trol73/avr-ic-tester/README.md

# avr-ic-tester

Тестер цифровых микросхем на atmega32 и дисплее от Nokia 5110

Описание проекта тут: http://trolsoft.ru/sch/ic_tester
