trol73/avr-ic-tester/circuit/tester-schematic.pdf

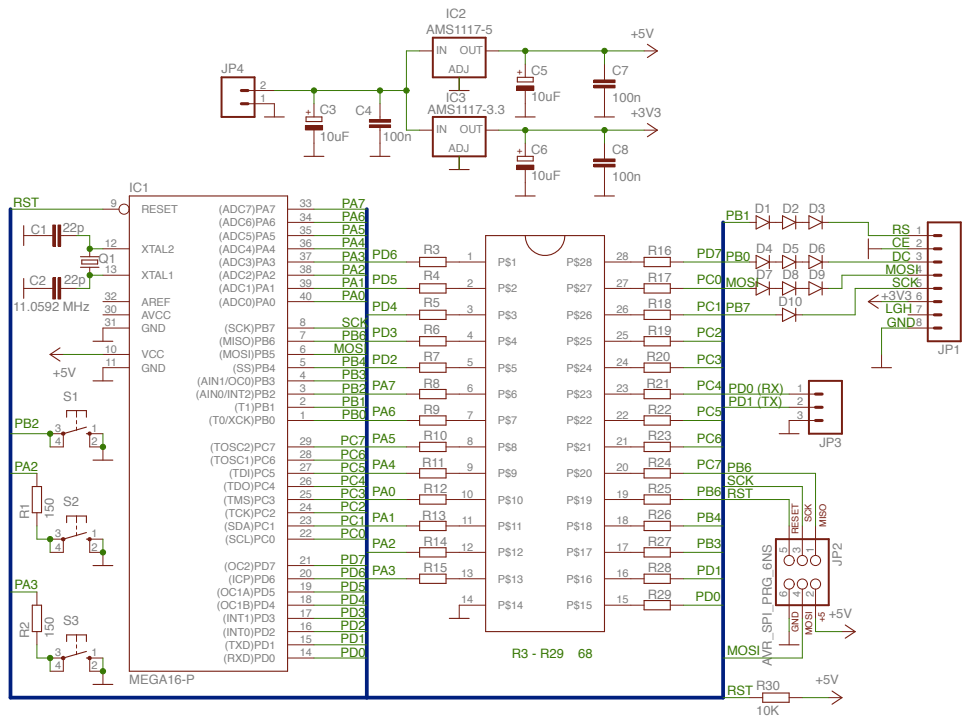
[picture p1: page 1]

GND 31 AVCC 30 AREF 32 | SCK

VCC 10 | PB6

MOSI | PD2 | P$5 5 | PC3

PC7 | PA5 | P$8 8 | PC6
PC6 | PA4 R11 | P$9 9 | R24 PC7

PA3 | P$13 13 | PD1
PD5 | | | R29 PD0
