trol73/avr-ic-tester/circuit/tester.brd

## EAGLE design circuit/tester.brd (2015-07-16)

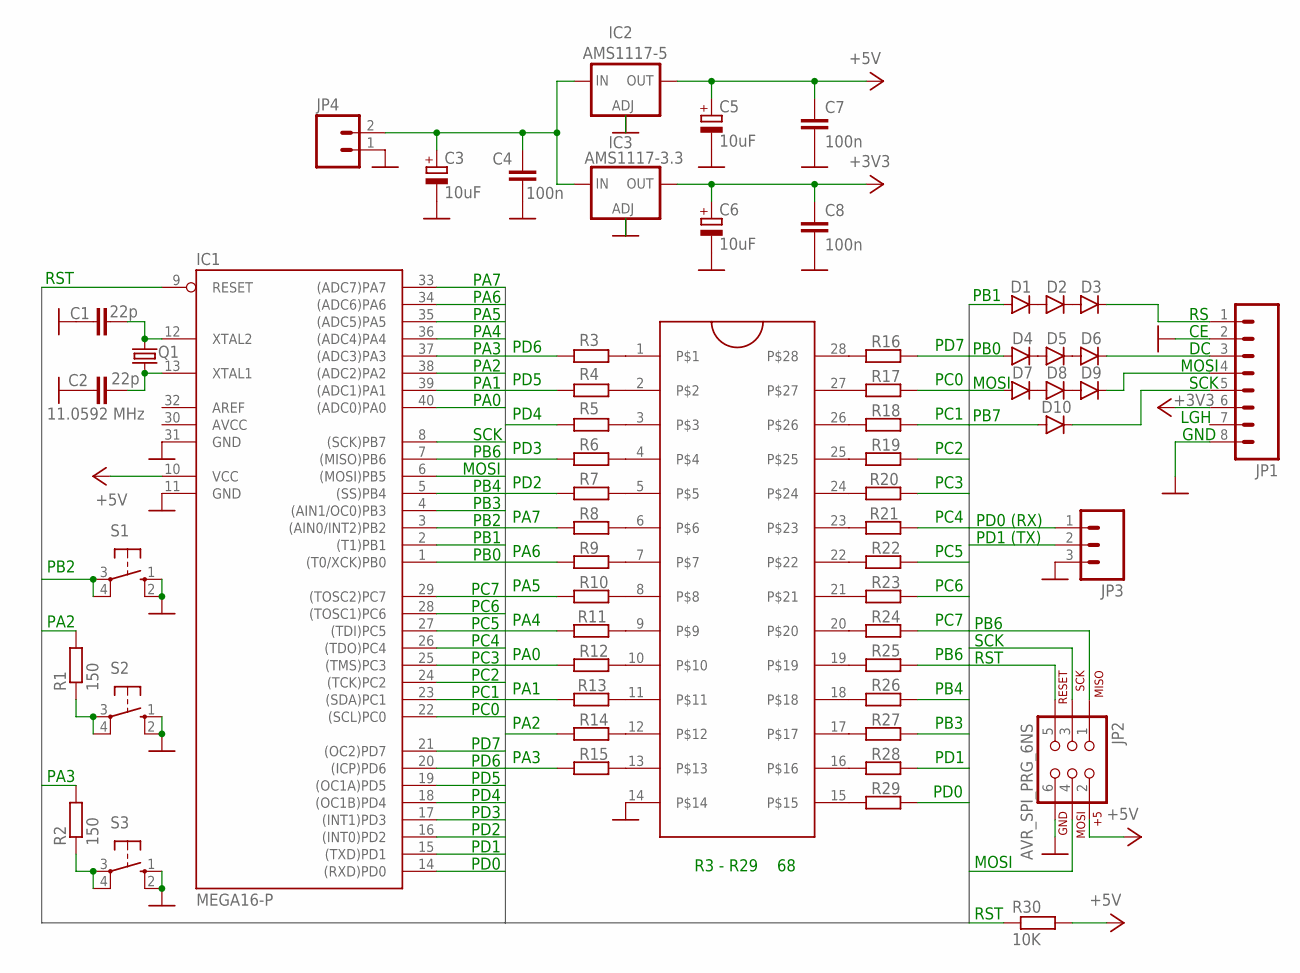
[picture p2: schematic tester.sch]

Parts:
C1, C2: 22p; C0805
C3, C5, C6: 10uF; E2,5-5
C4, C7, C8: 100n; C0805
D1, D2, D3, D4, D5, D6, D7, D8, D9, D10: DIODESOD123; SOD-123
IC1: MEGA16-P; DIL40
IC2: AMS1117-5; SOT223
IC3: AMS1117-3.3; SOT223
JP1: M08; 1X08_ROUND
JP2: AVR_SPI_PRG_6NS; 2X3-NS
JP3: M03PTH; 1X03
JP4: M02PTH; 1X02
Q1: 11.0592 MHz; HC49/S
R1, R2: 150; M0805
R3, R4, R5, R6, R7, R8, R9, R10, R11, R12, R13, R14, R15, R16, R17, R18, R19, R20, R21, R22, R23, R24, R25, R26, R27, R28, R29: R-EU_M0805; M0805
R30: 10K; M0805
S1, S2, S3: 10-XX; B3F-10XX
U$1: ZIFSOCKET-28-3ZIFFSOCKET-28-3; DIL28-3-ZIF_SOCKET

Connections:
+3V3: C6.+, C8.1, IC3.4 (OUT), JP1.6
+5V: C5.+, C7.1, IC1.10 (VCC), IC2.4 (OUT), JP2.2, R30.2
AVCC: IC1.30 (AVCC)
GND: C1.1, C2.1, C3.-, C4.1, C5.-, C6.-, C7.2, C8.2, IC1.11 (GND), IC1.31 (GND), IC2.1 (ADJ), IC3.1 (ADJ), JP1.2, JP1.8, JP2.6, JP3.3, JP4.1, S1.1 (S), S1.2 (S1), S2.1 (S), S2.2 (S1), S3.1 (S), S3.2 (S1), U$1.14
unnamed: C2.2, IC1.13 (XTAL1), Q1.1
unnamed: C1.2, IC1.12 (XTAL2), Q1.2
unnamed: R16.2, U$1.28
unnamed: R17.1, U$1.27
unnamed: R18.1, U$1.26
unnamed: R19.1, U$1.25
unnamed: R20.1, U$1.24
unnamed: R21.1, U$1.23
unnamed: R22.1, U$1.22
unnamed: R23.1, U$1.21
unnamed: R24.1, U$1.20
unnamed: R7.1, U$1.5
unnamed: R6.1, U$1.4
unnamed: R5.1, U$1.3
unnamed: R4.1, U$1.2
unnamed: R3.2, U$1.1
unnamed: R8.2, U$1.6
unnamed: R9.2, U$1.7
unnamed: R10.2, U$1.8
unnamed: R11.2, U$1.9
unnamed: R12.2, U$1.10
unnamed: R13.2, U$1.11
unnamed: R14.2, U$1.12
unnamed: R15.2, U$1.13
unnamed: R25.2, U$1.19
unnamed: R26.2, U$1.18
unnamed: R27.1, U$1.17
unnamed: R29.1, U$1.15
unnamed: R28.1, U$1.16
unnamed: C3.+, C4.2, IC2.3 (IN), IC3.3 (IN), JP4.2
unnamed: R2.1, S3.3, S3.4 (P1)
unnamed: R1.1, S2.3, S2.4 (P1)
unnamed: D3.C, JP1.1
unnamed: D1.C, D2.A
unnamed: D2.C, D3.A
unnamed: D6.C, JP1.3
unnamed: D4.C, D5.A
unnamed: D9.C, JP1.4
unnamed: D5.C, D6.A
unnamed: D7.C, D8.A
unnamed: D8.C, D9.A
unnamed: D10.C, JP1.5
PA0: IC1.40 ((ADC0)PA0), R12.1
PA1: IC1.39 ((ADC1)PA1), R13.1
PA2: IC1.38 ((ADC2)PA2), R1.2, R14.1
PA3: IC1.37 ((ADC3)PA3), R2.2, R15.1
PA4: IC1.36 ((ADC4)PA4), R11.1
PA5: IC1.35 ((ADC5)PA5), R10.1
PA6: IC1.34 ((ADC6)PA6), R9.1
PA7: IC1.33 ((ADC7)PA7), R8.1
PB0: D4.A, IC1.1 ((T0/XCK)PB0)
PB1: D1.A, IC1.2 ((T1)PB1)
PB2: IC1.3 ((AIN0/INT2)PB2), S1.3, S1.4 (P1)
PB3: IC1.4 ((AIN1/OC0)PB3), R27.2
PB4: IC1.5 ((SS)PB4), R26.1
PB5: D7.A, IC1.6 ((MOSI)PB5), JP2.4
PB6: IC1.7 ((MISO)PB6), JP2.1, R25.1
PB7: D10.A, IC1.8 ((SCK)PB7), JP2.3
PC0: IC1.22 ((SCL)PC0), R17.2
PC1: IC1.23 ((SDA)PC1), R18.2
PC2: IC1.24 ((TCK)PC2), R19.2
PC3: IC1.25 ((TMS)PC3), R20.2
PC4: IC1.26 ((TDO)PC4), R21.2
PC5: IC1.27 ((TDI)PC5), R22.2
PC6: IC1.28 ((TOSC1)PC6), R23.2
PC7: IC1.29 ((TOSC2)PC7), R24.2
PD0: IC1.14 ((RXD)PD0), JP3.1, R29.2
PD1: IC1.15 ((TXD)PD1), JP3.2, R28.2
PD2: IC1.16 ((INT0)PD2), R7.2
PD3: IC1.17 ((INT1)PD3), R6.2
PD4: IC1.18 ((OC1B)PD4), R5.2
PD5: IC1.19 ((OC1A)PD5), R4.2
PD6: IC1.20 ((ICP)PD6), R3.1
PD7: IC1.21 ((OC2)PD7), R16.1
RESET: IC1.9 (RESET), JP2.5, R30.1

Notes on the sheet:
MOSI
SCK
LGH
GND
PB7
PB6
RST
PB0
PB1
PB2
PA3
PA2
PD6
PD5
PD4
PD3
PD2
PA7
PA6
PA5
PA4
PA0
PA1
PD7
PC0
PC1
PC2
PC3
PC4
PC5
PC6
PC7
PB4
PB3
PD1
PD1 (TX)
PD0
PD0 (RX)
R3 - R29 68

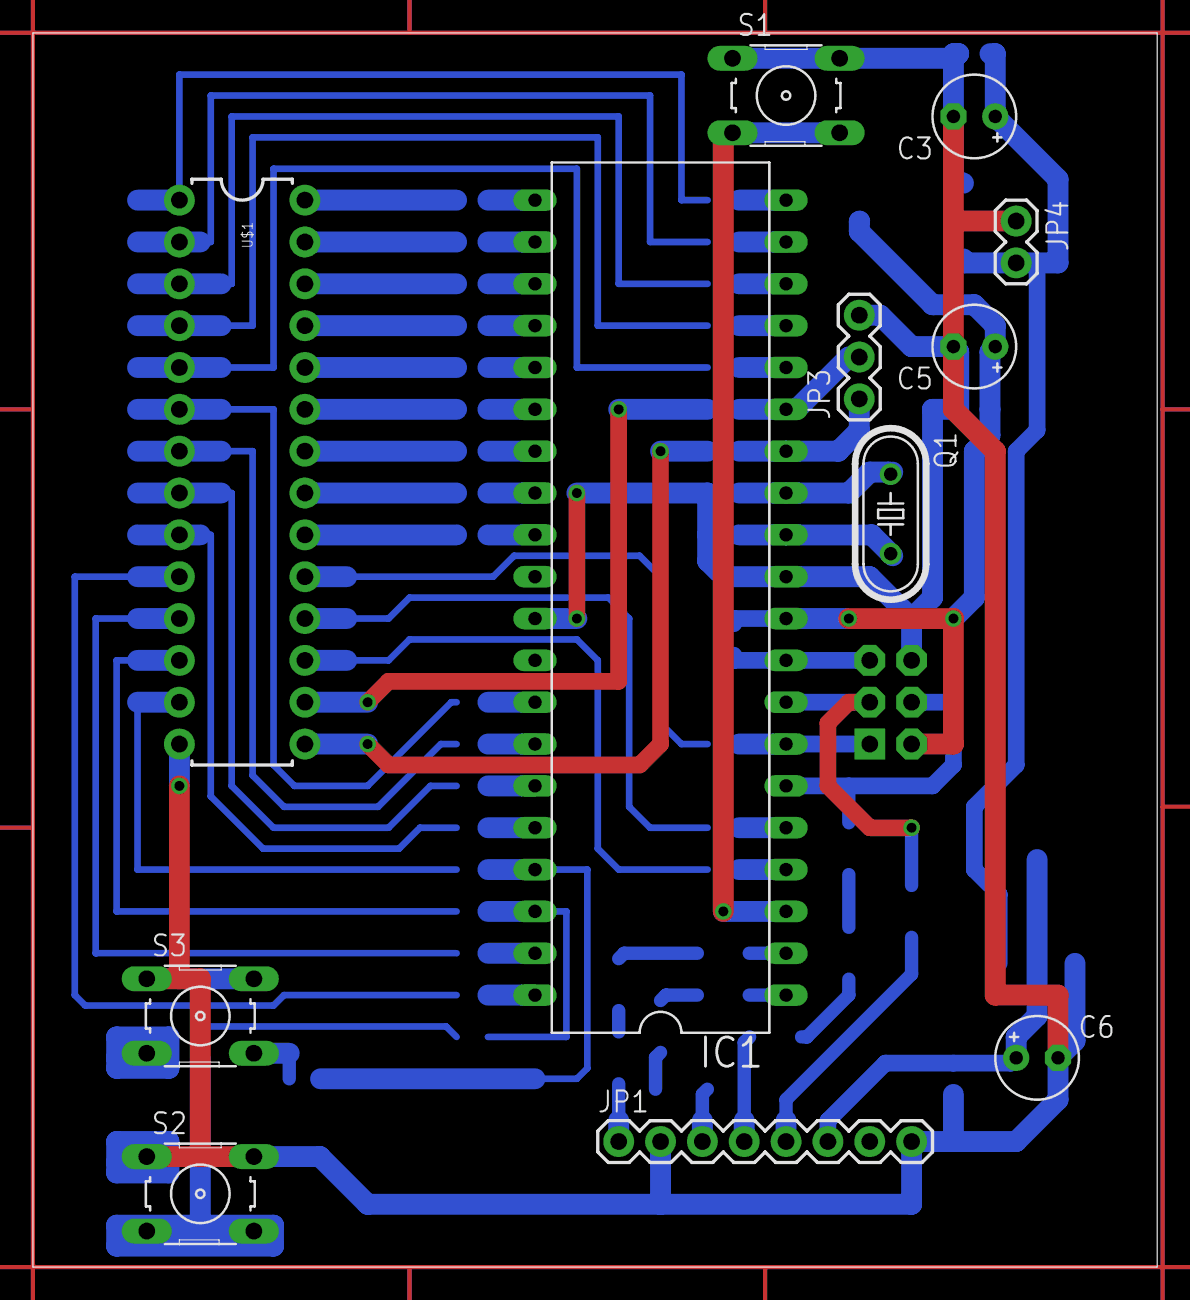
[picture p3: board tester.brd from above]

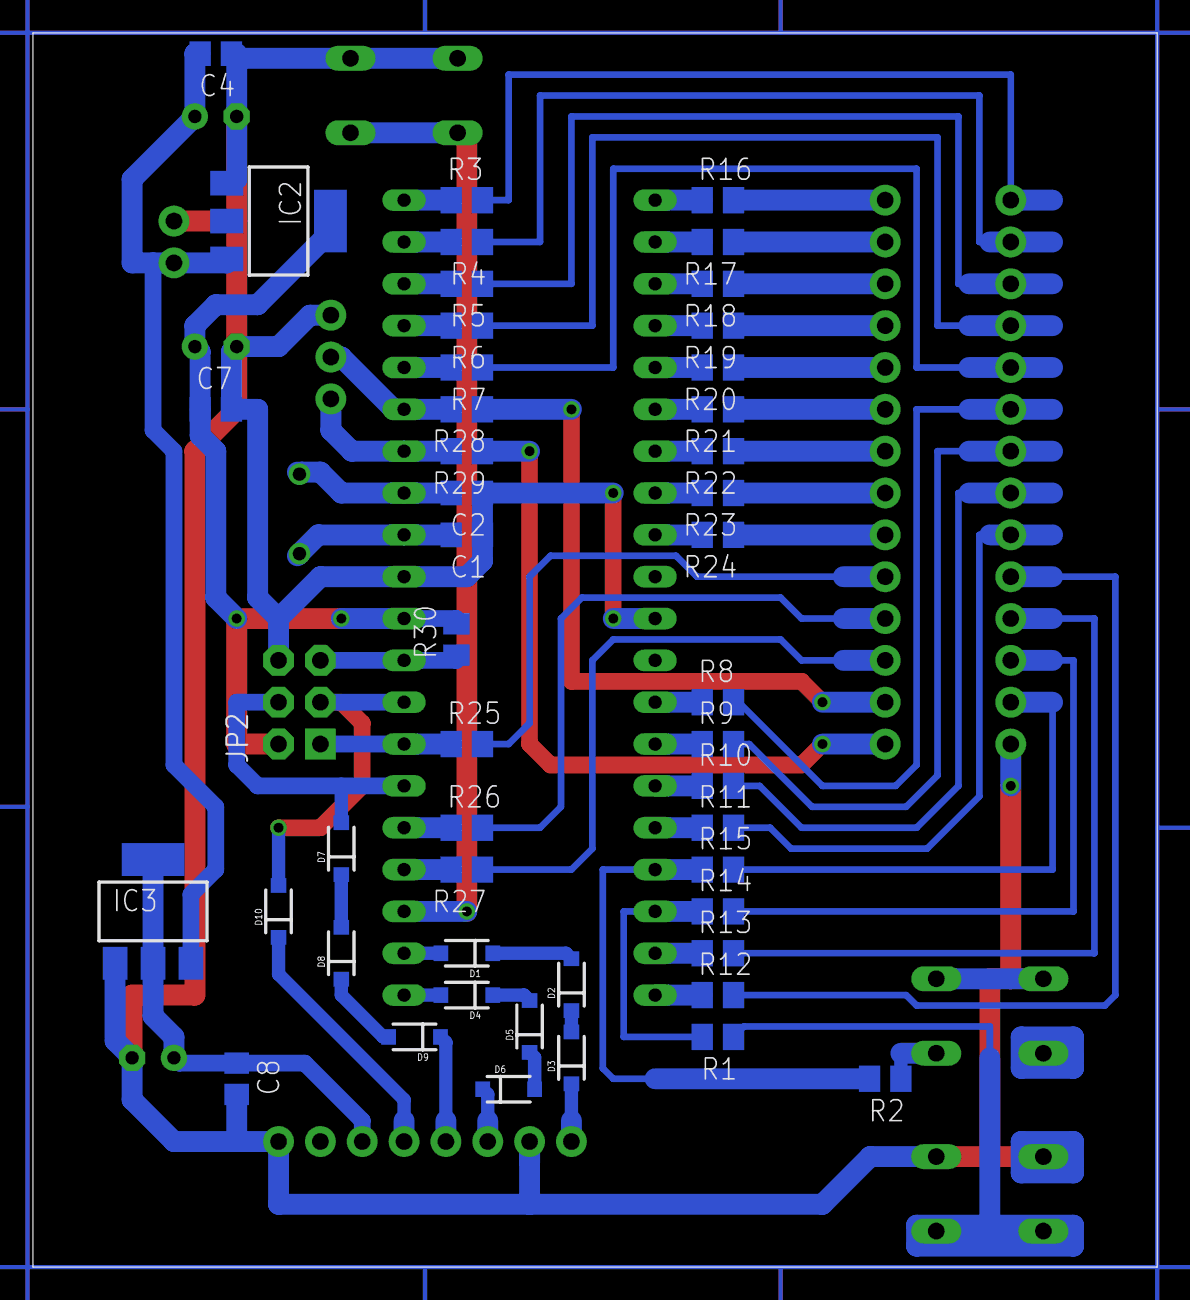
[picture p4: board tester.brd from below]

Board: 2 copper layers, 68.2 x 74.9 mm, 60 parts (48 on the bottom side), 78 nets.
