trol73/avr-ic-tester/ic-tester/data_ttl.h

const uint8_t LOGIC_DATA_TTL[] PROGMEM = {
	'Ê', 'Ð', '5', '1', '4', 'È', 'Ä', '2', 0,
	CMD_INIT_16, 0b00111111, 0b10000000,
	CMD_SET_ALL_AND_TEST_16, 0b10001100, 0b10000001, 0b10001100, 0b10000001,
	CMD_SET_ALL_AND_TEST_16, 0b10001000, 0b10000001, 0b10001000, 0b10000001,
	CMD_SET_ALL_AND_TEST_16, 0b11001000, 0b11111111, 0b11001000, 0b11111111,
	CMD_SET_ALL_AND_TEST_16, 0b11001100, 0b11111111, 0b10001100, 0b10000001,
	CMD_SET_ALL_AND_TEST_16, 0b11000100, 0b11111111, 0b10000100, 0b10100001,
	CMD_SET_ALL_AND_TEST_16, 0b11010100, 0b11111111, 0b11010100, 0b11110011,
	CMD_SET_ALL_AND_TEST_16, 0b11000101, 0b11111111, 0b10000101, 0b11000101,
	CMD_SET_ALL_AND_TEST_16, 0b11010101, 0b11111111, 0b11010101, 0b11000001,
	CMD_SET_ALL_AND_TEST_16, 0b11000110, 0b11111111, 0b11000110, 0b10010011,
	CMD_SET_ALL_AND_TEST_16, 0b11010110, 0b11111111, 0b11010110, 0b10001001,
	CMD_SET_ALL_AND_TEST_16, 0b11000111, 0b11111111, 0b10000111, 0b10001001,
	CMD_SET_ALL_AND_TEST_16, 0b11010111, 0b11111111, 0b11010111, 0b11100011,
	CMD_SET_ALL_AND_TEST_16, 0b11011100, 0b11111111, 0b11011100, 0b10000001,
	CMD_SET_ALL_AND_TEST_16, 0b11001101, 0b11111111, 0b10001101, 0b11011101,
	CMD_SET_ALL_AND_TEST_16, 0b11011101, 0b11111111, 0b11011101, 0b11011001,
	CMD_SET_ALL_AND_TEST_16, 0b11001110, 0b11111111, 0b11001110, 0b10010111,
	CMD_SET_ALL_AND_TEST_16, 0b11011110, 0b11111111, 0b11011110, 0b10001101,
	CMD_SET_ALL_AND_TEST_16, 0b11001111, 0b11111111, 0b10001111, 0b10011101,
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
	CMD_LAST_PULSE_AND_TEST_16, 0b01111111, 0b10011011,
	CMD_LAST_PULSE_AND_TEST_16, 0b01111111, 0b10111011,
	CMD_LAST_PULSE_AND_TEST_16, 0b01111111, 0b10000111,
	CMD_LAST_PULSE_AND_TEST_16, 0b01111111, 0b11100111,
	CMD_LAST_PULSE_AND_TEST_16, 0b01111111, 0b10000011,
	CMD_END,
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
