trol73/avr-ic-tester/ic-tester/ui.c

/*
 * ui.c
 *
 * Created: 27.07.2015 20:16:58
 *  Author: Trol
 */ 

#include "ui.h"

#include <string.h>
#include <stdio.h>

#include "lib/glcd/glcd.h"
#include "lib/glcd/fonts/font5x7.h"

#include "debug.h"

#include "keyboard.h"
#include "i18n.h"
#include "test.h"
#include "tester_io.h"
#include "memory_test.h"

#define LINES_PER_SCREEN			5	// строк на экране
#define LINES_DY					9	// расстояние между строками

#define STATUS_INSERT_CHIP		0	// ожидание установки микросхемы
#define STATUS_TESTING			1	// тестирование в процессе
#define STATUS_DONE				2	// тестирование завершено

#define STATUS_SETUP			0	// настройка пинов на ввод/вывод
#define STATUS_OUT				1	// установка уровней на выводах

uint8_t screen;
uint8_t selectedIndex;
uint8_t status;

uint8_t package;			// сколько выводов у микросхемы (ручной тест). тут же хранитя тип микросхемы (TTL/CMOS)



static void glcd_drawCenteredStr_p(const char *str, uint8_t y, uint8_t dx);
static void glcd_drawCenteredStr(const char *str, uint8_t y, uint8_t dx);


uint8_t GetScreen() {
	return screen;
}

void SetScreen(uint8_t s) {
	screen = s;
}


static void drawMainMenu() {
	glcd_drawCenteredStr_p(STR_AUTODETECT, 1, 1);
	glcd_drawCenteredStr_p(STR_CUSTOM_TEST, 1+LINES_DY, 1);
	glcd_drawCenteredStr_p(STR_MEM_TEST, 1+2*LINES_DY, 1);
	glcd_drawCenteredStr_p(STR_ABOUT, 1+3*LINES_DY, 1);
	
	// выделяем текущий
	glcd_invert_area(0, selectedIndex*LINES_DY, GLCD_LCD_WIDTH, LINES_DY);
}


static void drawChipAutoTest() {
	switch (status) {
		case STATUS_INSERT_CHIP:
			glcd_drawCenteredStr_p(STR_INSERT_CHIP, 10, 1);
			glcd_drawCenteredStr_p(STR_AND_PRESS_BUTTON, 18, 1);
			break;
		case STATUS_TESTING:
			glcd_drawCenteredStr_p(STR_TESTING, 16, 1);
			break;
		case STATUS_DONE:
//glcd_drawCenteredStr_p(STR_APPNAME, 15, 1);
//return;		
			if (selectedIndex) {
				InitDisplay();
				glcd_drawCenteredStr(GetDeviceName(), 0, 1);
			} else {
				InitDisplay();
				glcd_drawCenteredStr_p(STR_UNKNOWN_OR_FAILED, 15, 1);
			}		
			break;
	}

	
}

static void drawSelectPackageScreen() {
	glcd_drawCenteredStr_p(STR_BACK, 1, 1);
	glcd_drawCenteredStr_p(STR_DIP_8, 1+LINES_DY, 1);
	glcd_drawCenteredStr_p(STR_DIP_14, 1+2*LINES_DY, 1);
	glcd_drawCenteredStr_p(STR_DIP_16, 1+3*LINES_DY, 1);
	glcd_drawCenteredStr_p(STR_DIP_20, 1+4*LINES_DY, 1);
	
	// выделяем текущий
	glcd_invert_area(20, selectedIndex*LINES_DY, GLCD_LCD_WIDTH-40, LINES_DY);		
}

static void drawCustomTest() {
	// 84 x 48

	val24_t valuesDdr, valuesPort, valuesPin;

	ReadAll24(&valuesDdr, &valuesPort, &valuesPin);
	const uint8_t len = package/2;
	const uint8_t dx = 82 / len;
	for (uint8_t i = 0; i < len; i++) {
		uint8_t x = i*dx + 4;
		uint8_t y = i < 9 ? 38 : 36;
		
		// нижний ряд: 1..10
		uint8_t pin24 = i + 1;
		bool ddr = getPinVal24(&valuesDdr, pin24);
		bool pin = getPinVal24(&valuesPin, pin24);
		bool out = getPinVal24(&valuesPort, pin24);
		//if (ddr) pin = out;
		uint8_t io = pin ? 0 : 2;
		if (!ddr) {
			io++;
		}
		glcd_draw_char_xy_ex(x, y, 0x90 + i, false);
		glcd_draw_char_xy_ex(x, 40, 0xAC + io, false);	// io
		glcd_draw_char_xy_ex(x, y-6, 0xA5 + out, false);	// state

		// верхний ряд: 11..20
		uint8_t v = 2*len-i-1;		
		pin24 = v + 1 + 24 - package;
		ddr = getPinVal24(&valuesDdr, pin24);
		pin = getPinVal24(&valuesPin, pin24);
		out = getPinVal24(&valuesPort, pin24);
		//if (ddr) pin = out;
		io = pin ? 0 : 2;
		if (!ddr) {
			io++;
		}
		glcd_draw_char_xy_ex(x, 7, 0x90 + v, false);
		glcd_draw_char_xy_ex(x, 1, 0xA8 + io, false);	// io
		glcd_draw_char_xy_ex(x, v < 19 ? 13 : 15, 0xA5 + out, false);	// state
	}
	if (status == STATUS_SETUP) {
		glcd_draw_string_xy_P(11, 20, STR_SETUP);
	} else {
		glcd_draw_string_xy_P(11, 20, STR_OUT);
	}
	glcd_draw_string_xy_P(54, 20, STR_EXIT);

	//glcd_draw_char_xy(18, 20, '}');
	
	if (selectedIndex < len) {
		// нижний ряд пинов
		uint8_t x = selectedIndex*dx + 3;
		if (status == STATUS_OUT) {
			glcd_invert_area(x-1, 28, 9, 15);
		} else {
			if (selectedIndex == 9) {
				glcd_invert_area(x-1, 35, 9, 13);
			} else {
				glcd_invert_area(x-1, 37, 9, 11);
			}
		}
	} else if (selectedIndex < package) {
		// верхний ряд пинов
		uint8_t x = (2*len-selectedIndex-1)*dx + 3;
		if (status == STATUS_OUT) {
			glcd_invert_area(x-1, 4, 9, selectedIndex == 19 ? 18 : 16);	
		} else {
			glcd_invert_area(x-1, 0, 9, selectedIndex == 19 ? 15 : 13);		
		}
	} else if (selectedIndex == package) {
		// setup/out
		glcd_invert_area(9, 19, status == STATUS_SETUP ? 33 : 23, 10);
	} else {
		// exit
		glcd_invert_area(52, 19, 27, 10);
	}
	glcd_draw_rect(0, 4, 84, 40, 1);
	glcd_draw_char_xy_ex(1, 20, 0xA7, false);
}

static void drawMemoryTestResult() {
	const uint8_t step = 6;	// шаг сетки
	// сетка 8x8 ячеек размером 5x5
	for (uint8_t i = 0; i <= 8; i++) {
		glcd_draw_line(i*step, 0, i*step, 8*step, 1);
		glcd_draw_line(0, i*step-1, 8*step, i*step-1, 1);
	}

	if (MemGetRows() >= 8) {
		for (uint8_t row = 0; row < 8; row++) {
			for (uint8_t col = 0; col < 8; col++) {
				uint8_t res = MemTestGetCell(row, col);
				switch (res) {
					case TEST_CELL_GOOD:
						glcd_fill_rect(col*step + 2, row*step + 1, 3, 3, 1);
						break;
					case TEST_CELL_BAD:
						glcd_draw_line(col*step+2, row*step+1, col*step+4, row*step+3, 1);
						glcd_draw_line(col*step+2, row*step+3, col*step+4, row*step+1, 1);
						break;
					case TEST_CELL_UNKNOWN:
						glcd_draw_line(col*step+2, row*step+1, col*step+4, row*step+1, 1);
						glcd_draw_line(col*step+2, row*step+2, col*step+3, row*step+2, 1);
						glcd_draw_line(col*step+2, row*step+3, col*step+2, row*step+3, 1);
						break;
				}
			}
		}
	}
	glcd_draw_string_xy_P(55, 0, STR_CHIP);
	if (MemGetRows() == 8) {
		glcd_draw_string_xy_P(58, LINES_DY, STR_RU5);
		glcd_draw_string_xy_P(58, 2*LINES_DY, STR_4164);
	} else if (MemGetRows() == 9) {
		glcd_draw_string_xy_P(58, LINES_DY, STR_RU7);
		glcd_draw_string_xy_P(52, 2*LINES_DY, STR_41256);
	} else {
		glcd_draw_string_xy_P(58, LINES_DY, STR_NONE);
	}
}

static void drawMemoryTest() {
	switch (status) {
		case STATUS_INSERT_CHIP:
			glcd_drawCenteredStr_p(STR_INSERT_CHIP, 10, 1);
			glcd_drawCenteredStr_p(STR_AND_PRESS_BUTTON, 18, 1);
			break;
		case STATUS_TESTING:
			glcd_drawCenteredStr_p(STR_TESTING, 16, 1);
			break;
		case STATUS_DONE:
			drawMemoryTestResult();
			break;
	}
}

static void drawAboutScreen() {
	glcd_drawCenteredStr_p(STR_APPNAME, 0, 1);
	glcd_drawCenteredStr_p(STR_VERSION, 10, 1);
	glcd_drawCenteredStr_p(STR_COPYRIGHT_DATE, 20, 1);
	glcd_drawCenteredStr_p(STR_COPYRIGHT_NAME, 30, 1);
	glcd_drawCenteredStr_p(STR_COPYRIGHT_NAME_2, 40, 1);
}


static void drawSelectChipLogicScreen() {
	glcd_drawCenteredStr_p(STR_TTL, 1, 1);
	glcd_drawCenteredStr_p(STR_CMOS, 1+LINES_DY, 1);
	glcd_drawCenteredStr_p(STR_BACK, 1+2*LINES_DY, 1);
	
	// выделяем текущий
	glcd_invert_area(0, selectedIndex*LINES_DY, GLCD_LCD_WIDTH, LINES_DY);	
}

void Draw() {
	glcd_tiny_set_font(Font5x7, 5, 7, 32, 0xff);
	glcd_clear_buffer();

	switch(screen) {
		case SCREEN_MAIN_MENU:
			drawMainMenu();
			break;
		case SCREEN_CHIP_AUTO_TEST:
			drawChipAutoTest();
			break;
		case SCREEN_SELECT_PACKAGE:
			drawSelectPackageScreen();
			break;
		case SCREEN_CUSTOM_TESTER:
			drawCustomTest();
			break;
		case SCREEN_MEMORY_TEST:
			drawMemoryTest();
			break;
		case SCREEN_ABOUT:
			drawAboutScreen();
			break;
		case SCREEN_SELECT_CHIP_TYPE:
			drawSelectChipLogicScreen();
			break;
	}
	glcd_update_bbox(0, 0, GLCD_LCD_WIDTH-1, GLCD_LCD_HEIGHT-1);	// костыль для некоторых дисплеев
	glcd_write();
}




static void handleMainMenu(uint8_t key) {
	switch(key) {
		case KEY_UP:
			if (selectedIndex > 0) {
				selectedIndex--;
			}
			break;
		case KEY_DOWN:
			if (selectedIndex < 3) {
				selectedIndex++;
			}
			break;
		case KEY_TEST:
			if (selectedIndex == 0) {
				screen = SCREEN_SELECT_CHIP_TYPE;
				selectedIndex = 0;
			} else if (selectedIndex == 1) {
				screen = SCREEN_SELECT_PACKAGE;
				selectedIndex = 0;
			} else if (selectedIndex == 2) {
				screen = SCREEN_MEMORY_TEST;
				status = STATUS_INSERT_CHIP;
				MemInit();
			} else {
				screen = SCREEN_ABOUT;
			}
			break;
	}
}

static bool handleChipAutoTest(uint8_t key) {
	switch (status) {
		case STATUS_INSERT_CHIP:
			if (key == KEY_TEST) {
				status = STATUS_TESTING;
				Draw();
				selectedIndex = TestLogic(package);
				status = STATUS_DONE;
			}
			break;
		case STATUS_TESTING:
			return true;
		case STATUS_DONE:
			if (key == KEY_TEST) {
				selectedIndex = package;
				screen = SCREEN_SELECT_CHIP_TYPE;
			} else {
				return true;
			}
			break;
	}
	return false;
}

static void handleCustomTest(uint8_t key) {
	switch (key) {
		case KEY_UP:
			if (selectedIndex > 0) {
				selectedIndex--;
			} else {
				selectedIndex = package+1;
			}
			break;
		case KEY_DOWN:
			if (selectedIndex <= package) {
				selectedIndex++;
			} else {
				selectedIndex = 0;
			}
			break;
		case KEY_TEST:
			if (selectedIndex > package) {
				selectedIndex = 1;
				screen = SCREEN_MAIN_MENU;
			} else if (selectedIndex == package) {
				status = status == STATUS_SETUP ? STATUS_OUT : STATUS_SETUP;
			} else {
				if (status == STATUS_SETUP) {
					invertPinDirection(selectedIndex+1, package);
				} else {
					invertPinOut(selectedIndex+1, package);
				}
			}
			break;
	}
}

static void handleSelectPackage(uint8_t key) {
	switch(key) {
		case KEY_UP:
			if (selectedIndex > 0) {
				selectedIndex--;
			}
			break;
		case KEY_DOWN:
			if (selectedIndex < 4) {
				selectedIndex++;
			}
			break;
		case KEY_TEST:
			if (selectedIndex == 0) {
				screen = SCREEN_MAIN_MENU;
				selectedIndex = 1;
			} else {
				screen = SCREEN_CUSTOM_TESTER;
				if (selectedIndex == 1) {
					package = 8;
				} else if (selectedIndex == 2) {
					package = 14;
				} else if (selectedIndex == 3) {
					package = 16;
				} else {
					package = 20;
				}
				selectedIndex = 0;
				status = STATUS_SETUP;
			}
			break;
	}
}

static void handleMemoryTest(uint8_t key) {
	switch (status) {
		case STATUS_INSERT_CHIP:
			if (key == KEY_TEST) {
				status = STATUS_TESTING;
				Draw();
				MemTest();
				status = STATUS_DONE;
			} else {
				screen = SCREEN_MAIN_MENU;
				selectedIndex = 2;
			}
			break;
		case STATUS_DONE:
			if (key == KEY_TEST) {
				status = STATUS_INSERT_CHIP;
			} else {
				screen = SCREEN_MAIN_MENU;
				selectedIndex = 2;				
			}
			break;
	}
}

static void handleAbout(uint8_t key) {
	screen = SCREEN_MAIN_MENU;
}


static void handleSelectChip(uint8_t key) {
	switch(key) {
		case KEY_UP:
			if (selectedIndex > 0) {
				selectedIndex--;
			}
			break;
		case KEY_DOWN:
			if (selectedIndex < 2) {
				selectedIndex++;
			}
			break;
		case KEY_TEST:
			if (selectedIndex == 0) {
				package = TYPE_TTL;
				screen = SCREEN_CHIP_AUTO_TEST;
				status = STATUS_INSERT_CHIP;
			} else if (selectedIndex == 1) {
				package = TYPE_CMOS;
				screen = SCREEN_CHIP_AUTO_TEST;
				status = STATUS_INSERT_CHIP;
			} else if (selectedIndex == 2) {
				screen = SCREEN_MAIN_MENU;
				selectedIndex = 0;
			}
			break;
	}
}



void onKeyPressed(uint8_t key) {
	switch(screen) {
		case SCREEN_MAIN_MENU:
			handleMainMenu(key);
			break;
		case SCREEN_CHIP_AUTO_TEST:
			if (handleChipAutoTest(key)) {
				return;
			};
			break;
		case SCREEN_CUSTOM_TESTER:
			handleCustomTest(key);
			break;
		case SCREEN_SELECT_PACKAGE:
			handleSelectPackage(key);
			break;
		case SCREEN_MEMORY_TEST:
			handleMemoryTest(key);
			break;
		case SCREEN_ABOUT:
			handleAbout(key);
			break;
		case SCREEN_SELECT_CHIP_TYPE:
			handleSelectChip(key);
			break;
	}
	Draw();	
}


void InitDisplay() {
	glcd_init();
#ifdef DISPLAY_CONTRAST
	glcd_set_contrast(DISPLAY_CONTRAST);
#else
	glcd_set_contrast(100);
#endif
	glcd_clear();
	glcd_clear();
	//	glcd_tiny_set_font(Font5x7, 5, 7, 32, 0xff);
}

// Рисует строку, отцентрированную по горизонтали
static void glcd_drawCenteredStr_p(const char *str, uint8_t y, uint8_t dx) {
	uint8_t len = strlen_P(str);
	uint8_t x = (GLCD_LCD_WIDTH - len*5 - (len-1)*dx)/2;
	while (1) {
		char c = pgm_read_byte(str++);
		if (!c) {
			return;
		}
		x += glcd_draw_char_xy(x, y, c) + dx;
		c++;
	}
}


static void glcd_drawCenteredStr(const char *str, uint8_t y, uint8_t dx) {
	uint8_t len = strlen(str);
	uint8_t x;
	if (len <= 15) {
		x = (GLCD_LCD_WIDTH - len*5 - (len-1)*dx)/2;
	} else {
		x = 0;
	}
	uint8_t i = 0;
	while (len > 0) {
		char c = str[i++];
		if (!c) {
			return;
		}
		x += glcd_draw_char_xy(x, y, c) + dx;
		if (x > GLCD_LCD_WIDTH - 6) {
			x = 0;
			y += 10;
		}
		len--;
		//c++;
	}
}
