trol73/avr-ic-tester/ic-tester/data_cmos.h

const uint8_t LOGIC_DATA_CMOS[] PROGMEM = {
	'È', 'Ð', '2', ',', 'C', 'D', '4', '0', '1', '5', 0,
	CMD_INIT_16, 0b11100001, 0b11100001,
	CMD_SET_ALL_AND_TEST_16, 0b01100000, 0b11100000, 0b01100000, 0b11100000,
	CMD_SET_ALL_16, 0b01000000, 0b11000000,
	CMD_PULSE_PLUS, 21,
	CMD_TEST_ALL_16, 0b01010000, 0b11000001,
	CMD_PULSE_PLUS, 1,
	CMD_TEST_ALL_16, 0b01010001, 0b11010001,
	CMD_PULSE_PLUS, 21,
	CMD_TEST_ALL_16, 0b01011001, 0b11010001,
	CMD_PULSE_PLUS, 1,
	CMD_TEST_ALL_16, 0b01011001, 0b11011001,
	CMD_PULSE_PLUS, 21,
	CMD_TEST_ALL_16, 0b01011101, 0b11011001,
	CMD_PULSE_PLUS, 1,
	CMD_TEST_ALL_16, 0b01011101, 0b11011101,
	CMD_PULSE_PLUS, 21,
	CMD_TEST_ALL_16, 0b01011101, 0b11011111,
	CMD_PULSE_PLUS, 1,
	CMD_TEST_ALL_16, 0b01011111, 0b11011111,
	CMD_END,

	'È', 'Ä', '1', ',', 'C', 'D', '4', '0', '2', '8', 0,
	CMD_INIT_16, 0b10000000, 0b10011110,
	CMD_SET_ALL_AND_TEST_16, 0b00000000, 0b10000000, 0b00000100, 0b10000000,
	CMD_SET_ALL_AND_TEST_16, 0b00000000, 0b10000010, 0b00000000, 0b10100010,
	CMD_SET_ALL_AND_TEST_16, 0b00000000, 0b10010000, 0b00000010, 0b10010000,
	CMD_SET_ALL_AND_TEST_16, 0b00000000, 0b10010010, 0b00000000, 0b11010010,
	CMD_SET_ALL_AND_TEST_16, 0b00000000, 0b10001000, 0b00000001, 0b10001000,
	CMD_SET_ALL_AND_TEST_16, 0b00000000, 0b10001010, 0b00100000, 0b10001010,
	CMD_SET_ALL_AND_TEST_16, 0b00000000, 0b10011000, 0b01000000, 0b10011000,
	CMD_SET_ALL_AND_TEST_16, 0b00000000, 0b10011010, 0b00001000, 0b10011010,
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
	CMD_SET_ALL_AND_TEST_16, 0b00001000, 0b10000000, 0b00001000, 0b10000000,
	CMD_SET_ALL_AND_TEST_16, 0b00101001, 0b10010000, 0b00101001, 0b10010000,
	CMD_SET_ALL_AND_TEST_16, 0b00001100, 0b11000010, 0b00001100, 0b11000010,
	CMD_END,

	CMD_END
};
