trol73/avr-ic-tester/ic-tester/ui.h

/*
 * ui.h
 *
 * Created: 27.07.2015 20:17:00
 *  Author: Trol
 */ 

#ifndef _UI_H_
#define _UI_H_

#include <stddef.h>
#include <stdlib.h>
#include <stdbool.h>
#include <stdint.h>


#define SCREEN_MAIN_MENU				0
#define SCREEN_CHIP_AUTO_TEST			1
#define SCREEN_MEMORY_TEST				2
#define SCREEN_ABOUT						3
#define SCREEN_SELECT_PACKAGE			4
#define SCREEN_CUSTOM_TESTER			5
#define SCREEN_SELECT_CHIP_TYPE		6

void InitDisplay();

uint8_t GetScreen();
void SetScreen(uint8_t screen);

void Draw();

void onKeyPressed(uint8_t key);



#endif	// _UI_H_
