trol73/avr-ic-tester/(commit log)

2015-07-16 added eagle project
    [tester.brd, tester.sch]
2015-07-19 155 ИД 7 команда TEST xxx => yyy
2015-07-19 частично реализована работа с ИМС с количеством выводов > 16 пока есть ошибки и требуется рефакторинг расширена БД и исправлен компилятор
    [data.h, tester_io.c]
2015-07-21 оптимизация и приведения кода к единообразию
2015-07-21 рефакторинг завершен, осталось починить работу с DIP-20
2015-07-22 исправлена ошибка проверки DIP-28 проверка ИР23
    [tester_io.c]
2015-07-22 добавлен ТВ9
2015-07-23 Добавлены микросхемы
2015-07-24 добавлена заготовка теста РУ-шек
2015-07-24 ИЕ7, ИЕ2
2015-07-26 добавлено несколько микросхем
2015-07-27 заготовка для меню
2015-07-27 добавлены библиотеки
2015-07-27 тест РУ-шек (пока не работает)
2015-07-28 исправлена ошибка подачи питания на РУ-шки
    [memory_test.c]
2015-07-28 исправлены методы работы с РУ-шками. написание теста памяти пока в процессе
    [memory_test.c, tester_io.c, ui.c]
2015-07-29 работа над тестером РУшек
2015-07-30 тесп памяти готов
2015-07-30 добавлены АП3, АП4, АП5
2015-07-31 добавлены ИР16 и ИР34 тестирование DIP-24 и DIP-28 требует особой работы с клавиатурой, эта логика еще не завершена
2015-08-01 тестирование длинных микросхем завершено
2015-08-01 расширена база тестов
2015-08-03 добавлен КП12
2015-08-04 добавлена схема в pdf
2015-08-07 интерфейс для ручных тестов в процессе
2015-08-08 реализован режим ручного тестирования
2015-08-08 расширена база, исправлен компилятор
    [data.h]
2015-08-09 расширена база микросхем компилятор теперь поддерживает микросхемы где входы/выходы могут меняться местами
2015-08-10 вывод списка микросхем в базе для компилятора
2015-08-12 рефакторинг компилятора
2015-08-13 оптимизирован компилятор
2015-08-13 добавлены новые команды в прошивку оптимизатор пока не работает
2015-08-14 доделываю компилятор
2015-08-14 исправлен компилятор
2015-08-14 версия 0.5 отключена отладка, исправлены баги
    [data.h, i18n.h, keyboard.c, memory_test.c, test.c, test.h]
2015-11-02 added gerber files
2015-11-23 Fixed display issues (reproduced with some instances of 5110)
    [i18n.h, ui.c]
2015-11-23 fixed CMOS test issue
    [test.c]
